sparkfunX/Qwiic_MP3_Trigger/Hardware/Qwiic MP3 Trigger.brd

## EAGLE design Hardware/Qwiic MP3 Trigger.brd (2020-06-30)

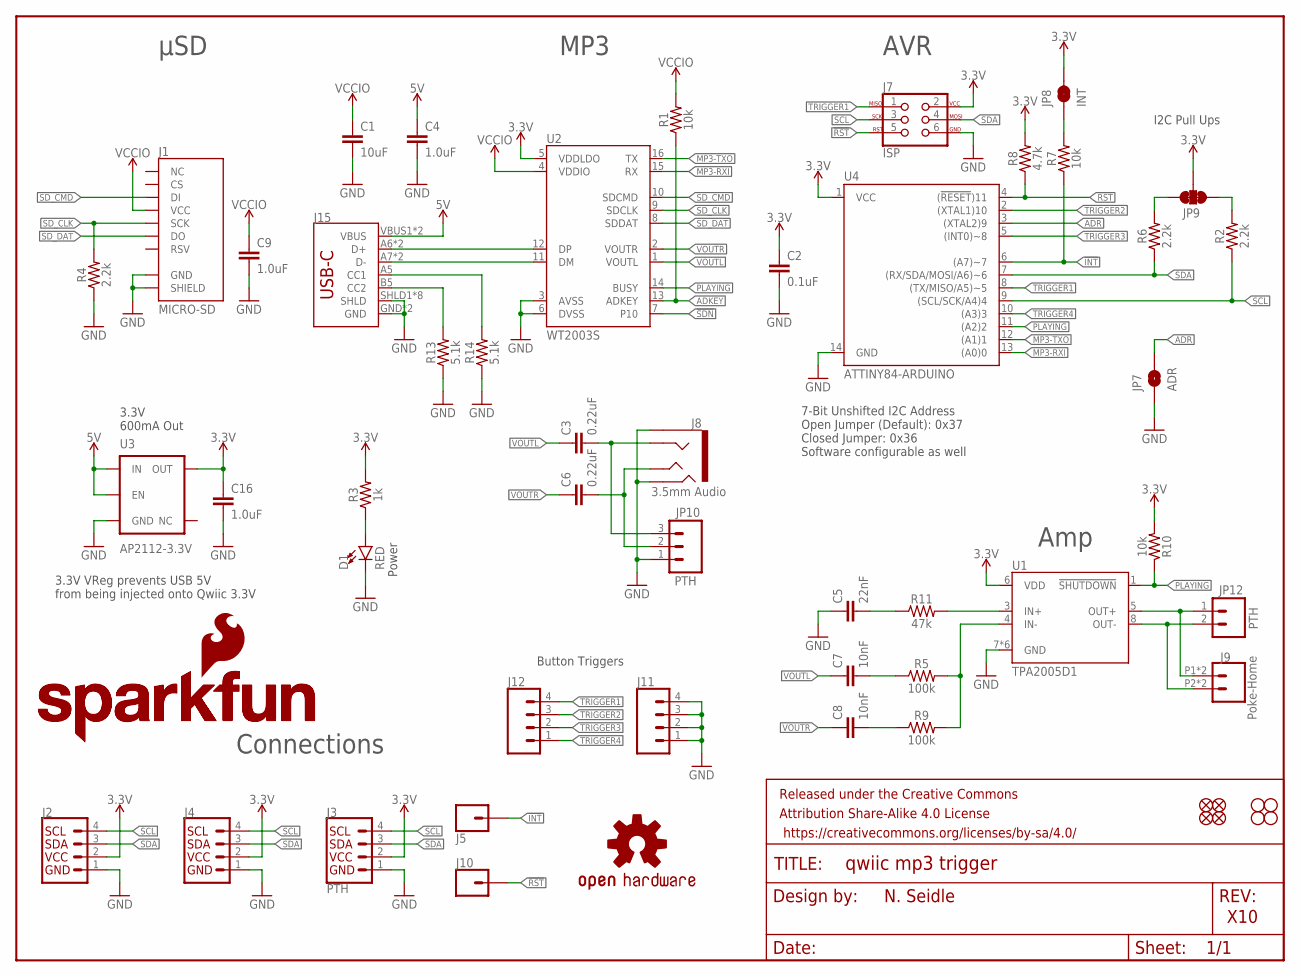
[picture p1: schematic Qwiic MP3 Trigger.sch]

Parts:
C1: 10uF; 0603
C2: 0.1uF; 0603
C3, C6: 0.22uF; 0603
C4, C9, C16: 1.0uF; 0603
C5: 22nF; 0603
C7, C8: 10nF; 0603
D1: RED; LED-0603
FRAME1: FRAME-LETTER; CREATIVE_COMMONS
J1: MICRO-SD; MICRO-SD-SOCKET
J2, J4: QWIIC_CONNECTORJS-1MM; 1X04_1MM_RA
J3: PTH; 1X04_NO_SILK
J5, J10: CONN_01PTH_NO_SILK_YES_STOP; 1X01_NO_SILK
J7: ISP; 2X3_TEST_POINTS
J8: 3.5mm Audio; AUDIO_JACK_3.5MM_TRRS_SMD_RA
J9: Poke-Home; 1X02_POKEHOME
J11, J12: CONN_041X04_NO_SILK; 1X04_NO_SILK
J15: USB_C16PIN; USB-C-16P
JP1, JP2, JP5, JP6: FIDUCIALUFIDUCIAL; MICRO-FIDUCIAL
JP3, JP4, JP11, JP13: STAND-OFF
JP7: ADR; SMT-JUMPER_2_NO_SILK
JP8: INT; SMT-JUMPER_2_NC_TRACE_SILK
JP9: JUMPER-SMT_3_2-NC_TRACE_SILK; SMT-JUMPER_3_2-NC_TRACE_SILK
JP10: PTH; 1X03_NO_SILK
JP12: PTH; 1X02_NO_SILK
LOGO1: OSHW-LOGOMINI; OSHW-LOGO-MINI
LOGO2: SFE_LOGO_NAME.1_INCH; SFE_LOGO_NAME_.1
LOGO3: SFE_LOGO_NAME_FLAME.1_INCH; SFE_LOGO_NAME_FLAME_.1
R1, R7, R10: 10k; 0603
R2, R4, R6: 2.2k; 0603
R3: 1k; 0603
R5, R9: 100k; 0603
R8: 4.7k; 0603
R11: 47k; 0603
R13, R14: 5.1k; 0603
U1: TPA2005D1; QFN-8_PAD
U2: WT2003S; SO16
U3: AP2112-3.3V; SOT23-5
U4: ATTINY84-ARDUINO; SO14

Connections:
3.3V: C2.1, C16.1, J2.2, J3.2 (VCC), J4.2, J7.2, JP8.2, JP9.2, R3.2, R8.2, R10.2, U1.6 (VDD), U2.5 (VDDLDO), U3.5 (OUT), U4.1 (VCC)
5V: C4.1, J15.VBUS1 (VBUS), J15.VBUS2 (VBUS), U3.1 (IN), U3.3 (EN)
!INT: J5.1, R7.1, U4.6 ((A7)~7)
!RST: J7.5, J10.1, R8.1, U4.4 ((!RESET!)11)
!SDN: U2.7 (P10)
AC-L: C3.2, J8.RING1, JP10.3
AC-R: C6.2, J8.TIP, JP10.2
ADKEY: R1.1, U2.13 (ADKEY)
ADR: JP7.2, U4.3 ((XTAL2)9)
D+: J15.A6 (D+), J15.B6 (D+), U2.12 (DP)
D-: J15.A7 (D-), J15.B7 (D-), U2.11 (DM)
GND: C1.2, C2.2, C4.2, C5.1, C9.2, C16.2, D1.C, J1.CD1 (SHIELD), J1.GND, J2.1, J3.1 (GND), J4.1, J7.6, J8.EARTH, J8.RING2, J11.1, J11.2, J11.3, J11.4, J15.GND, J15.GND2 (GND), J15.SHLD1 (SHLD), J15.SHLD2 (SHLD), J15.SHLD3 (SHLD), J15.SHLD4 (SHLD), J15.SHLD5 (SHLD), J15.SHLD6 (SHLD), J15.SHLD7 (SHLD), J15.SHLD8 (SHLD), JP7.1, JP10.1, R4.1, R13.1, R14.1, U1.7 (GND), U1.9 (GND), U1.10 (GND), U1.11 (GND), U1.12 (GND), U1.13 (GND), U2.3 (AVSS), U2.6 (DVSS), U3.2 (GND), U4.14 (GND)
IN+AMP: R11.2, U1.3 (IN+)
IN-AMP: R5.2, R9.2, U1.4 (IN-)
MP3-RXI: U2.15 (RX), U4.13 ((A0)0)
MP3-TXO: U2.16 (TX), U4.12 ((A1)1)
unnamed: J15.B5 (CC2), R13.2
unnamed: J15.A5 (CC1), R14.2
unnamed: D1.A, R3.1
unnamed: JP8.1, R7.2
unnamed: C8.2, R9.1
unnamed: C5.2, R11.1
unnamed: C7.2, R5.1
OUT+: J9.P1 (1), J9.P3 (1), JP12.1, U1.5 (OUT+)
OUT-: J9.P2 (2), J9.P4 (2), JP12.2, U1.8 (OUT-)
PLAYING: R10.1, U1.1 (!SHUTDOWN), U2.14 (BUSY), U4.11 ((A2)2)
SCL: J2.4, J3.4 (SCL), J4.4, J7.3, R2.1, U4.9 ((SCL/SCK/A4)4)
SCL_PU1: JP9.1, R2.2
SDA: J2.3, J3.3 (SDA), J4.3, J7.4, R6.1, U4.7 ((RX/SDA/MOSI/A6)~6)
SDA_PU1: JP9.3, R6.2
SD_CLK: J1.SCLK (SCK), R4.2, U2.9 (SDCLK)
SD_CMD: J1.DI, U2.10 (SDCMD)
SD_DAT: J1.DO, U2.8 (SDDAT)
TRIGGER1: J7.1, J12.4, U4.8 ((TX/MISO/A5)~5)
TRIGGER2: J12.3, U4.2 ((XTAL1)10)
TRIGGER3: J12.2, U4.5 ((INT0)~8)
TRIGGER4: J12.1, U4.10 ((A3)3)
VCCIO: C1.1, C9.1, J1.VCC, R1.2, U2.4 (VDDIO)
VOUTL: C3.1, C7.1, U2.1 (VOUTL)
VOUTR: C6.1, C8.1, U2.2 (VOUTR)

Notes on the sheet:
N. Seidle
X10
Power
7-Bit Unshifted I2C Address Open Jumper (Default): 0x37 Closed Jumper: 0x36 Software configurable as well
I2C Pull Ups
Button Triggers
3.3V VReg prevents USB 5V from being injected onto Qwiic 3.3V
3.3V 600mA Out
μSD
MP3
AVR
Amp
Connections

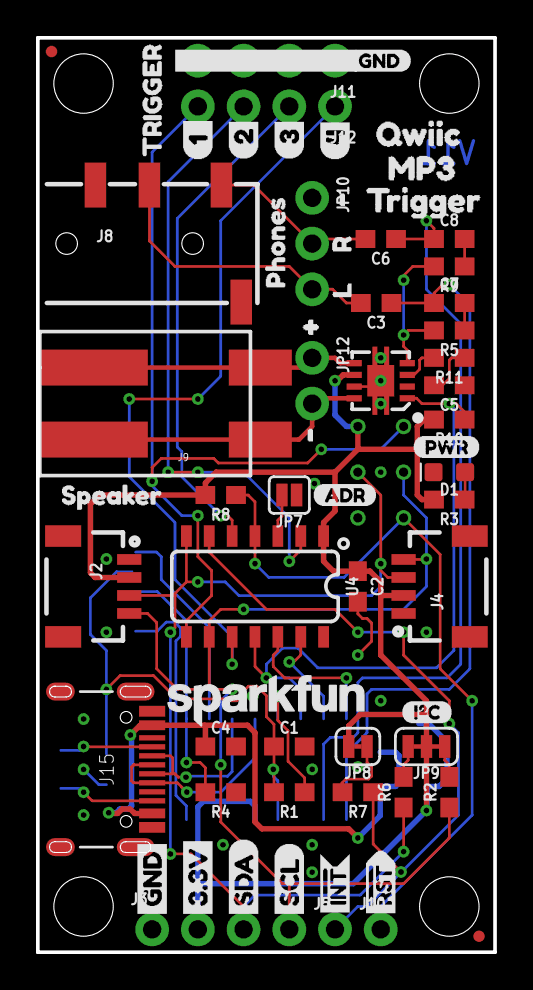
[picture p2: board Qwiic MP3 Trigger.brd from above]

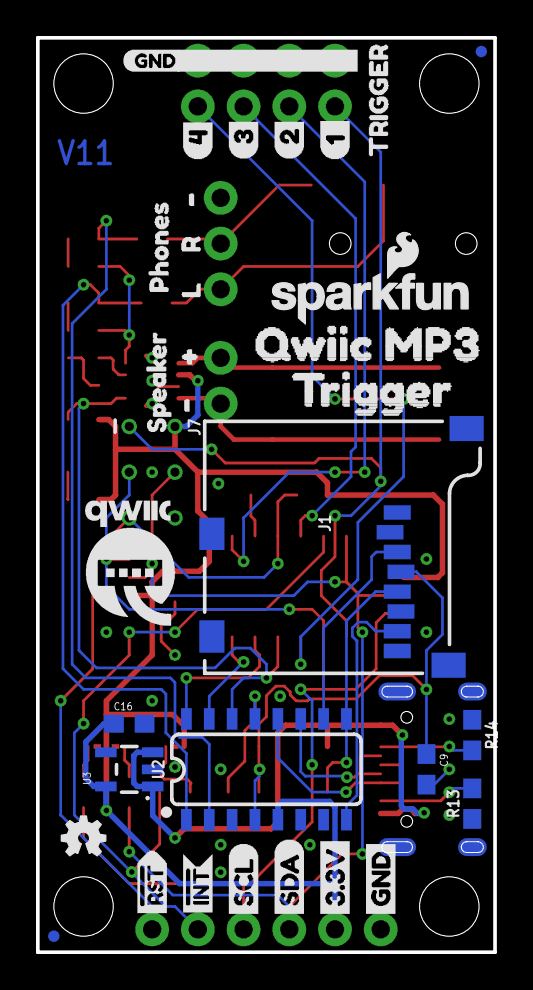
[picture p3: board Qwiic MP3 Trigger.brd from below]

Board: 2 copper layers, 25.4 x 50.8 mm, 104 parts (34 on the bottom side), 39 nets.

Other parts of the board:
U$1: MP31
U$3, U$22: GND1
U$4, U$21: 3#3V2
U$5, U$27: SDA8
U$6, U$26: SCL9
U$7, U$16: RST#-[>
U$8: I_SUPER2_C-()-03
U$9, U$11: INT#-[<
U$10, U$13, U$25, U$38: #6
U$12, U$28: #5
U$14, U$20: SPEAKER1
U$15, U$40: PHONES0
U$17: PWR-()-03
U$18: ADR-()-03
U$19, U$44: 1_1
U$23: QWIIC0
U$24: QWIIC_MP32
U$29, U$45: TRIGGER5
U$31, U$34: 43
U$32, U$42: 21
U$33, U$36: 32
U$35, U$46: GND0
U$37, U$41: L12
U$39, U$43: R11
U$47: QWIIC-LOGO-MEDIUM
U$49: TRIGGER4
U$50: TRIGGER2
