sparkfunX/Qwiic_MP3_Trigger/(threads)

Thread 1 (2018-05-09):

P10 pin not working

nseidle, 2018-05-09:
Pin is low at power up. Goes high during play. But stays high after song is stopped. This causes the amp to stay enabled after a song is complete and causes buzzing.

The BUSY pin does work as expected. Perhaps we wire the BUSY pin to the amp SDN pin.

nseidle, 2018-11-29:
Should be fixed on v10

Closed 2018-11-29.

Thread 3 (2018-06-03):

Documentation in firmware has incorrect i2c command values

querry43, 2018-06-03:
The comment header for Qwiic_MP3_Controller.ino lists the command values incorrectly.  As one example, it has:

> 0x0A : Get firmware version : 2 bytes, upper ver and lower ver

when the actual value is:

> #define COMMAND_GET_VERSION 0x0C

nseidle, 2018-06-04:
Good catch! Thanks for reporting the issue. I think I've updated the main firmware ino with the correct commands. Let me know if there's anything else that has issues.

Closed 2018-06-04.
