sparkfunX/Qwiic_MP3_Trigger/(commit log)

2020-06-30 Modify RCs on amp input to match impedance. Should reduce pop and gain a bit.
    [Qwiic MP3 Trigger.brd, Qwiic MP3 Trigger.sch]
2020-06-30 Increment version number on sch
    [Qwiic MP3 Trigger.sch]
